The-Public-Radio/Firmware/masthead.jpg

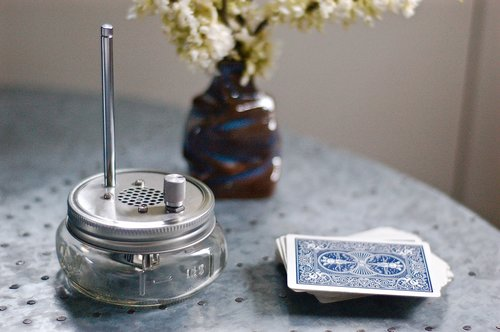
masthead.jpg
