The-Public-Radio/Firmware/One-touch_Programming_Jig/One-touch byte 0x01.png

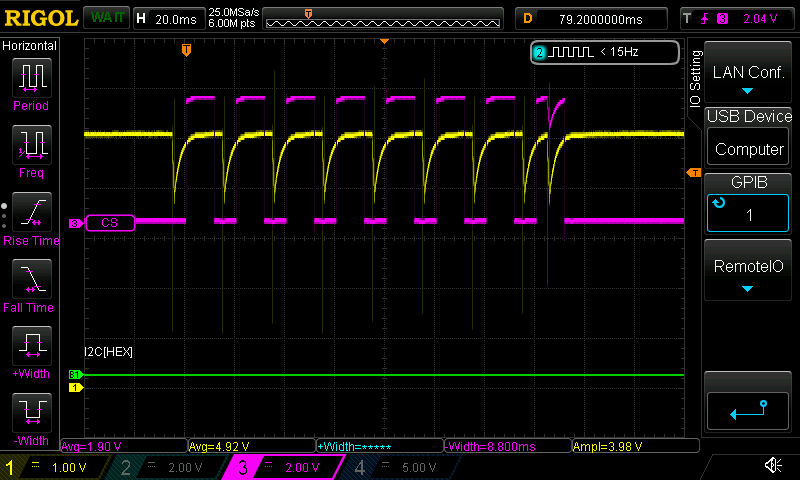
One-touch_Programming_Jig/One-touch byte 0x01.png
