The-Public-Radio/Firmware/One-touch_Programming_Jig/One-touch byte 0x55.png

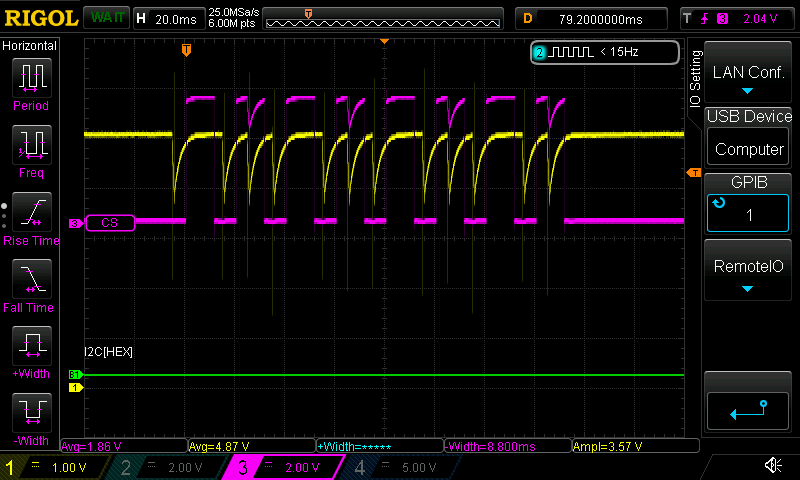
One-touch_Programming_Jig/One-touch byte 0x55.png
