The-Public-Radio/Firmware/One-touch_Programming_Jig/One-touch byte 0x80.png

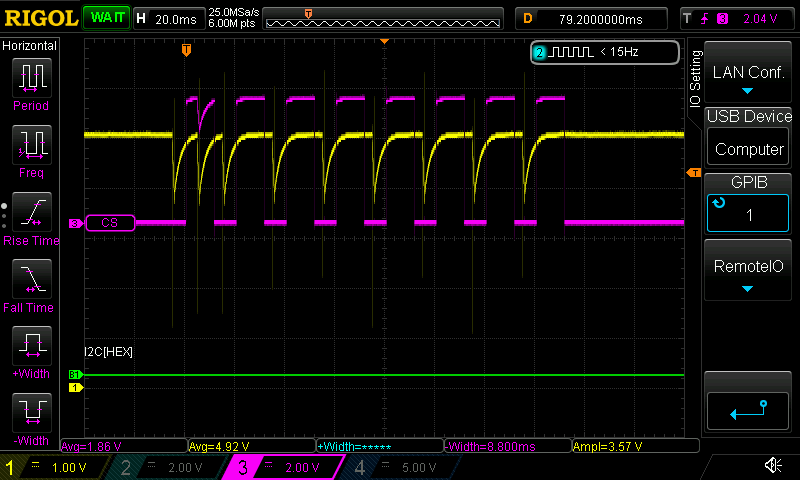
One-touch_Programming_Jig/One-touch byte 0x80.png
