The-Public-Radio/Firmware/(threads)

Thread 11 (2017-09-02):

Sleep is *so* low power now that we coast on decoupling caps and so don't power down for a while when old batteries are removed.

pencerw, 2017-09-02:
@bigjosh this is a weird one. once this happens, how do you get the radio to turn back on?

bigjosh, 2017-09-02:
On the new production unit I have, it takes about a minute for enough charge to bleed off the caps for the unit to actually turn off.  Note that at these low current levels, this is dependent on stuff like humidity and fingerprints on the PCB.

This would mean an instruction like...

> REPLACING DEAD BATTERIES
> Remove the dead batteries and then leave them out for a full 2 minutes before installing the new batteries. If you install the new batteries without waiting long enough, the unit might not turn on.

pencerw, 2017-09-02:
Wait - what happens if I let the batteries drain fully? The unit won't turn
on at all afterwards?

On Fri, Sep 1, 2017 at 10:18 PM, Josh Levine <notifications@github.com>
wrote:

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

--
pencerw.com <http://pencerw.com/feed>
@pencerw <http://twitter.com/pencerw>

bigjosh, 2017-09-02:
Once batteries get below the threshold voltage, then the unit will go deep sleep (after blinking for a couple minutes). At this point the batteries are too low to run the FM_IC, but not *that* low.

Once in deep sleep, the board only pulls about 3uA. At this rate, the batteries are basically draining at their internal leak rate and should last for the rest of their rated shelf life before draining completely and blistering.

So accurate (and unhelpful) answer: The batteries should not drain fully.

Likely more helpful answer is that once the battery voltage drops below the threshold voltage and the LED has stopped blinking, then the unit will appear to be dead - even though the ATTINY is actually still on and running.

If you pull the batteries at this point, the ATTINY *keeps* running because the power stored in the decoupling caps is enough to keep it going. So if you pull the low batteries and quickly put in fresh ones, the ATTINY does not even know anything happened - it was running just fine the whole time.

If, however, you pull the low batteries and wait for a couple of minutes before inserting the fresh ones, then then ATTINY has time to use up the power in the caps and turn off. Now when you put in the fresh batteries, the ATTINY turns on, see good voltage present, and starts normal operation.

So, with current software that uses deep sleep to prevent battery blistering, you must wait a couple of minutes between removing low batteries and putting in new ones or else unit will appear to be dead when fresh ones are put in. You can always take the fresh ones out again and wait, say, 5 minutes (longer because the fresh batteries recharged the caps even higher than they were) and reinsert and unit will power up fine. Make sense?

With current hardware, there will be a fundamental trade-off, the less power you use in sleep (thus the lower chance of blistering  batteries), the longer you have to keep the unit unpowered when changing out low batteries.

Good solutions are hardware - either reduce the amount of decoupling caps or make a physical way to short out the residual power like maybe having the knob short out the power rails.

There are software solutions like having the ATTINY periodically wake and check to see if the voltage has gone up significantly, and if so then go back to operation mode. But this will use more power exactly when we are trying to not use power to avoid blistering.

All make sense?

Maybe want to try depopulating all the caps again and see (1) if this reduces the coast time enough that a reasonable person can not change the batteries fast enough to have this problem, and (2) no other bad side effects of loosing those caps?

pencerw, 2017-09-02:
Got it - thanks for the explainer! I like how this folds into your "let's
ditch all the decoupling caps" thing too :)

My inclination is to keep the ATTINY in deep sleep, i.e. NOT wake up
periodically, to make sure we don't blow any batteries up.

I think we have about a week, week and a half to decide whether we can
depopulate those caps - we're running an additional 90 radios this week and
will probably release SMT on the balance after we've proven out the Tulip
process. So, if you think that's a reasonably likely fix then I'm fine
moving forward on that this week.

If we *don't* fix this, at least we have an easy solution: Tell people to
wait 5 minutes. That's not ideal but as long as nothing's actually breaking
it isn't the end of the world.

On Sat, Sep 2, 2017 at 12:59 AM, Josh Levine <notifications@github.com>
wrote:

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

--
pencerw.com <http://pencerw.com/feed>
@pencerw <http://twitter.com/pencerw>

Thread 5 (2017-09-02):

there is a short audio pop on powerup

pencerw, 2017-09-02:

pencerw, 2017-10-02:
moving this to https://github.com/The-Public-Radio/Embedded_Hardware/issues/6

Closed 2017-10-02.

Thread 6 (2017-09-02):

periodically check battery level while running

pencerw, 2017-09-02:

pencerw, 2017-09-02:
@bigjosh you said on your repo that this was on but maybe not working - can i help test it?

bigjosh, 2017-09-02:
This is working, but we need to tweek it. It is a little tricky because when there are loud sounds the amp chip often pulls enough juice that it lowers the battery voltage significantly,  but only for a very short time. We don't want to turn off every-time there is a load part in a song, so probably want to add in some kind of an averaging filter.  It will take experiments to figure out the right windows and right voltages to turn off when the battery is really too low for reliable operation, without turning off too soon and reducing battery life.

Thread 8 (2017-09-02):

revisit LED behavior

pencerw, 2017-09-02:
@bigjosh can you recap LED behavior in the current firmware? i find the initial breath pattern to be a bit confusing, but maybe that's just because i'm not clear on what's going on.

bigjosh, 2017-09-02:
All should be here...

https://github.com/bigjosh/Firmware/blob/dev/Firmware/README.MD

See anything inconsistent with that?

pencerw, 2017-09-02:
ah, this is great. i'll play around with a radio a bit and see how it feels.

On Fri, Sep 1, 2017 at 9:45 PM, Josh Levine <notifications@github.com>
wrote:

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

--
pencerw.com <http://pencerw.com/feed>
@pencerw <http://twitter.com/pencerw>

Thread 12 (2017-09-03):

change startup breathe pattern from 2 min to just 5 cycles

pencerw, 2017-09-03:

bigjosh, 2017-09-03:
Always 5 breaths after start up? Does pushing a button reset the counter?

bigjosh, 2017-09-04:
bump

bigjosh, 2017-09-04:
@pencerw bump

pencerw, 2017-09-04:
@bigjosh sorry for the delay! i'm inclined to say "yes" and "yes", which looks like how the current firmware is set - correct?

ZachDunham, 2017-09-04:
Chiming in on this too. Pushing a button should reset the counter. That
seems like a reasonable and consistent interaction.

On Mon, Sep 4, 2017 at 6:17 PM, Spencer Wright <notifications@github.com>
wrote:

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

--
zachdunham.com  <http://www.zachdunham.com>

bigjosh, 2017-09-05:
Commit on my repo here...
https://github.com/bigjosh/Firmware/commit/c6482c8373432e38426572b27450d75ef1a73f7f

Release firmware here (for ATTINY25 only)...
https://github.com/bigjosh/Firmware/releases/tag/KS2V0007

Program it up and LMK if this is right.

pencerw, 2017-09-05:
this looks good!

On Tue, Sep 5, 2017 at 3:10 PM, Josh Levine <notifications@github.com>
wrote:

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

--
pencerw.com <http://pencerw.com/feed>
@pencerw <http://twitter.com/pencerw>

Closed 2017-10-02.
