The-Public-Radio/Firmware/(commit log)

2014-01-22 Added existing sketches
    PR4001 works and is what I’ve been using up to this point. PR4002 was
    started but never finished.
    Both require PR_Header.h and PR_Source.c
2017-01-16 Updated Firmware
    Jumping to PR9021 though we should maybe using a different naming
    convention for firmware so as not to be confused with older versions of
    hardware.
    Adding an updated main.c file which implements low battery cutoff
    functionality at 2.1V. Some notes are in the readme.
2017-06-09 Fixup USI_TWI_state
    Previously was ugly and would generate a compile error...
    avr-gcc -mmcu=attiny45 -Wall -Os -g --std=c99 -c USI_TWI_Master.c
    USI_TWI_Master.c:47: warning: declaration does not declare anything
    Should really replace that whole TWI mess with a few lines of simple
    bitbangs. Someday if more room needed.
    [USI_TWI_Master.c]
2017-06-09 Backported TWI fix to PR9020
    [USI_TWI_Master.c]
2017-06-10 Typecast to prevent floating point from getting pulled in
    [VccADC.c, VccADC.h, main.c]
2017-06-17 ReadVccVoltage replaced with VCC_GT
    More efficient and better orgainized
    [main.c]
2017-06-17 Testing sleep currents with amp and FM IC powered down
2017-06-18 Rewrote USI stuff for pull-ups, but not working
    The signals look fine, maybe I meesed something up on the PCB? Reverting
    both hardware and software to see.
    [USI_TWI_Master.c, USI_TWI_Master.h, main.c]
2017-06-18 Gut rehab, but TWI stuff not working yet. Why?
    [USI_TWI_Master.c, USI_TWI_Master.h, main.c]
2017-06-20 Slight clean of button code. Need to make that an ISR.
2017-06-20 Button works. Advances station.
2017-06-20 Update button behavior, and README to match
2017-06-20 Works with breath and nice button code. Starting to trim.
2017-06-20 Implemented "factory settings' on startup button down, but don't like it.
2017-06-20 Lengthen save LED blink to 500ms
2017-06-20 Confirmed low power in sleep.
    Not as low as I'd like, but more likely due to amp and FMIC
2017-06-21 Do not play after proramming pulse - not enough power with current jig
2017-06-24 Interim recover afer windows update reboot! Ahhh!!!
    [main.c]
2017-06-24 Solid base working. Missing LED gamma and periodic battery check. Fits in 2K.
    Program Memory Usage : 2000 bytes 48.8 % Full
    Data Memory Usage : 33 bytes 12.9 % Full
    [main.c]
2017-06-27 Fixed rare LED fade glitch! Undocumented Timer0 behavior! Ahhh!
    Program Memory Usage : 1988 bytes 48.5 % Full
    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
    [main.c]
2017-07-06 Hack in LED brightness adjustment for PCB with no current limit resistor
2017-08-08 Cleanup, low power sleep everywhere, periodic battery check in there (but needs refinement)
2017-08-08 Broke out warn and cold low battery voltages since voltage drops durring operation.
    [main.c]
2017-08-18 Direct drive LED
2017-09-05 Tweek warm shutdown volts
2017-09-05 Change breath timeout to 5 cycles after start or button press. unused function clean-out.
2017-09-12 Add some votlage display diagnostics
    Blink the LED to make a multimeter.
2017-09-15 Update low battery voltages to favor longer runtime. Move cold bat check.
    Move cold battery check after 500ms xtal startup to give power time to
    stabilze after switch bounce.
2017-09-15 Update low battery voltages and seqence to favor longer runtime
    Make warm voltage so low that it will only trigger after unit has
    stopped working.
    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
2017-09-28 Increase warm cutout votlage to 1.8V. Made the test function into a macro to avoid type problems.
    [VccADC.h, main.c]
2017-09-28 Added filter that needs 10 consecutive low voltage samples to shut down
2017-09-29 Added ability to wake from deep sleep after undervoltage with a button press.
    This solves the problem of the unwakeable unit that keeps coasting on
    the decoupling caps.
    [main.c]
2017-09-29 Shutdown peripherals in sleep - has no measurable effect on power
2017-09-29 Burn power to discharge caps durring battery change.
    [main.c]
2017-12-02 Updated Firmware
    Changed over from pulsing LED pattern to combat FM receiver noise on startup. The LED pattern is now as follows:
    ~2sec full on @ startup
    150 ms blink on button press
    500 ms blink on save station
    !! There is still a known bug !!
    After saving a station, the following button press is not read. It takes two button presses after a save in order to increment a station. This needs to be fixed.
    NOTES: The corresponding hex file will have this commit ID attached.
    [USI_TWI_Master.c, USI_TWI_Master.h, VccADC.c, VccADC.h, main.c]
2017-12-14 Firmware correction
    This is the *actual* new firmware that should be with our latest hex file (https://github.com/The-Public-Radio/ops_tools/blob/master/data/3044a9415d9b2becb2ee44bd759a0c9f6be66109.hex)
    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
    [USI_TWI_Master.c, USI_TWI_Master.h, VccADC.c, VccADC.h, main.c]
